opiopan/Track-Cam/README.md

trackCAM
---

trackCAM is a shield board for Raspberry Pi to realize 2 axis tracking camera controll capability and RC TX collaboration capability.

<p align="center">
description
</p>
