opiopan/Track-Cam/pcb/Track-Cam.brd

## EAGLE design pcb/Track-Cam.brd (2019-01-09)

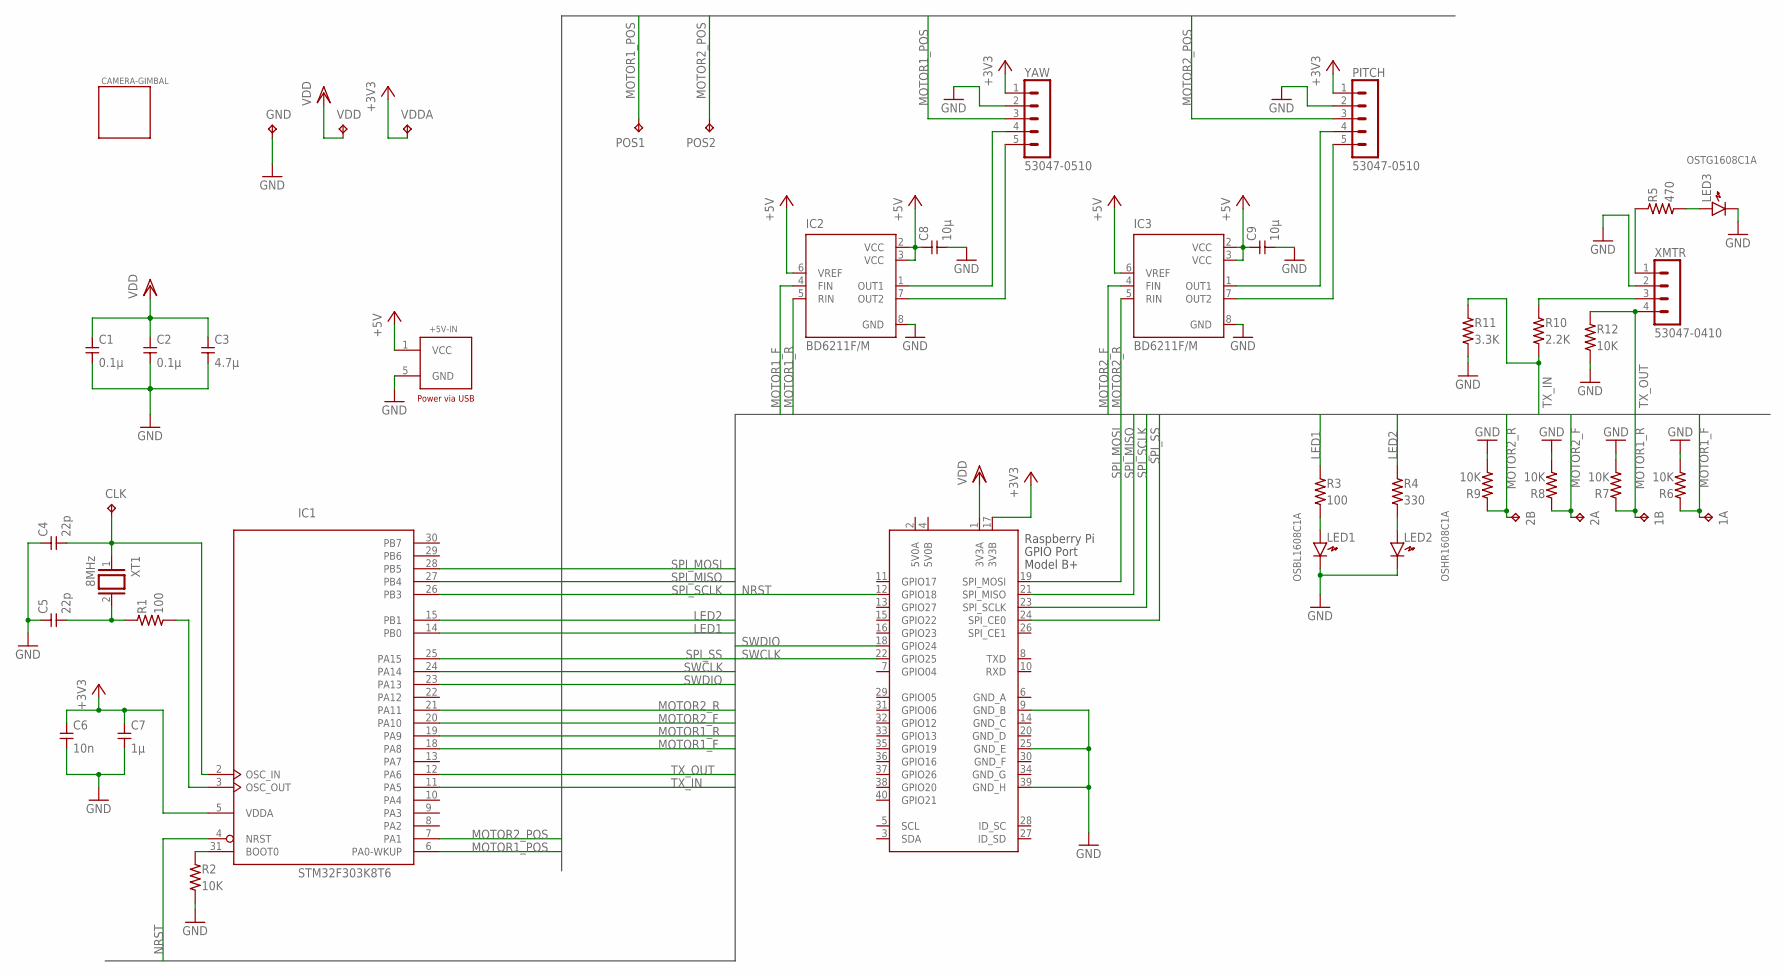
[picture p1: schematic Track-Cam.sch]

Parts:
1A, 1B, 2A, 2B: TPB1,27; B1,27
+5V-IN: MRUSB-2B-D14NI-S306/M; MICRO-USB-POWER/M
C1, C2: 0.1μ; SMD2012
C3: 4.7μ; SMD2012
C4, C5: 22p; SMD1608
C6: 10n; SMD2012
C7: 1μ; SMD2012
C8, C9: 10μ; SMD2012
CAMERA-GIMBAL: SG-90-CAMERA-MOUNT/NR; SG90-CAMERA-MOUNT-NR
CLK: TPB1,27; B1,27
GND: TPB1,27; B1,27
IC1: STM32F303K8T6; LQFP32-M
IC2, IC3: BD6211F/M; SOP8/M
LED1, LED2, LED3: LED1608
P1: RASPI_BOARD_B+#_HC; RASPI_BOARD_B+HAT_CF
PITCH: 53047-0510
POS1, POS2: TPB1,27; B1,27
R1, R3: 100; SMD2012
R2, R6, R7, R8, R9, R12: 10K; SMD2012
R4: 330; SMD2012
R5: 470; SMD2012
R10: 2.2K; SMD2012
R11: 3.3K; SMD2012
VDD: TPB1,27; B1,27
VDDA: TPB1,27; B1,27
XMTR: 53047-0410
XT1: 8MHz; QS
YAW: 53047-0510

Connections:
5V0A: P1.2 (5V0A)
5V0B: P1.4 (5V0B)
+3V3: C6.1, C7.1, IC1.5 (VDDA), P1.17 (3V3B), PITCH.1, VDDA.TP, YAW.1
+5V: +5V-IN.1 (VCC), C8.1, C9.1, IC2.2 (VCC), IC2.3 (VCC), IC2.6 (VREF), IC3.2 (VCC), IC3.3 (VCC), IC3.6 (VREF)
BOOT0: IC1.31 (BOOT0), R2.1
GND: +5V-IN.5 (GND), C1.2, C2.2, C3.2, C4.1, C5.1, C6.2, C7.2, C8.2, C9.2, GND.TP, IC1.16 (GND), IC1.32 (GND), IC2.8 (GND), IC3.8 (GND), LED1.K, LED2.K, LED3.K, P1.9 (GND_B), P1.25 (GND_E), P1.39 (GND_H), PITCH.2, R2.2, R6.2, R7.2, R8.2, R9.2, R11.2, R12.2, XMTR.2, YAW.2
GND_A: P1.6 (GND_A)
GND_C: P1.14 (GND_C)
GND_D: P1.20 (GND_D)
GND_F: P1.30 (GND_F)
GND_G: P1.34 (GND_G)
LED1: IC1.14 (PB0), R3.1
LED2: IC1.15 (PB1), R4.1
MOTOR1+: IC2.1 (OUT1), YAW.4
MOTOR1-: IC2.7 (OUT2), YAW.5
MOTOR1_F: 1A.TP, IC1.18 (PA8), IC2.4 (FIN), R6.1
MOTOR1_POS: IC1.6 (PA0-WKUP), POS1.TP, YAW.3
MOTOR1_R: 1B.TP, IC1.19 (PA9), IC2.5 (RIN), R7.1
MOTOR2+: IC3.1 (OUT1), PITCH.4
MOTOR2-: IC3.7 (OUT2), PITCH.5
MOTOR2_F: 2A.TP, IC1.20 (PA10), IC3.4 (FIN), R8.1
MOTOR2_POS: IC1.7 (PA1), PITCH.3, POS2.TP
MOTOR2_R: 2B.TP, IC1.21 (PA11), IC3.5 (RIN), R9.1
unnamed: C5.2, R1.1, XT1.2
unnamed: LED1.A, R3.2
unnamed: LED2.A, R4.2
unnamed: R5.1, XMTR.1
unnamed: LED3.A, R5.2
NRST: IC1.4 (NRST), P1.12 (GPIO18)
OSC_IN: C4.2, CLK.TP, IC1.2 (OSC_IN), XT1.1
OSC_OUT: IC1.3 (OSC_OUT), R1.2
SPI_MISO: IC1.27 (PB4), P1.21 (SPI_MISO)
SPI_MOSI: IC1.28 (PB5), P1.19 (SPI_MOSI)
SPI_SCLK: IC1.26 (PB3), P1.23 (SPI_SCLK)
SPI_SS: IC1.25 (PA15), P1.24 (SPI_CE0)
SWCLK: IC1.24 (PA14), P1.22 (GPIO25)
SWDIO: IC1.23 (PA13), P1.18 (GPIO24)
TX_IN: IC1.11 (PA5), R10.2, R11.1
TX_IN_5V: R10.1, XMTR.3
TX_OUT: IC1.12 (PA6), R12.1, XMTR.4
VDD: C1.1, C2.1, C3.1, IC1.1 (VDD), IC1.17 (VDD), P1.1 (3V3A), VDD.TP

Notes on the sheet:
OSBL1608C1A
OSHR1608C1A
OSTG1608C1A

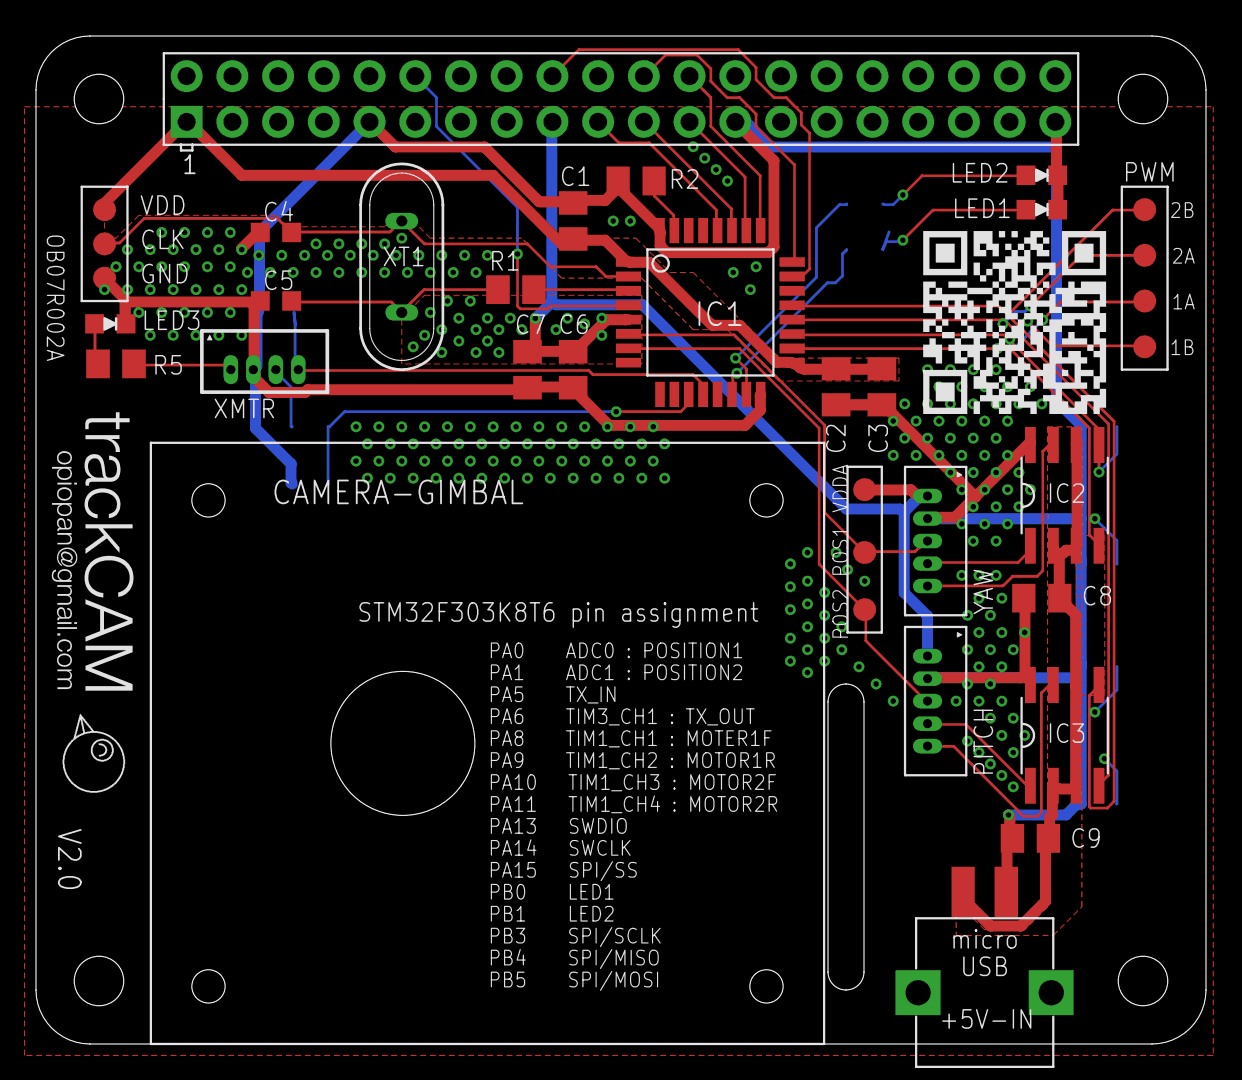
[picture p2: board Track-Cam.brd from above]

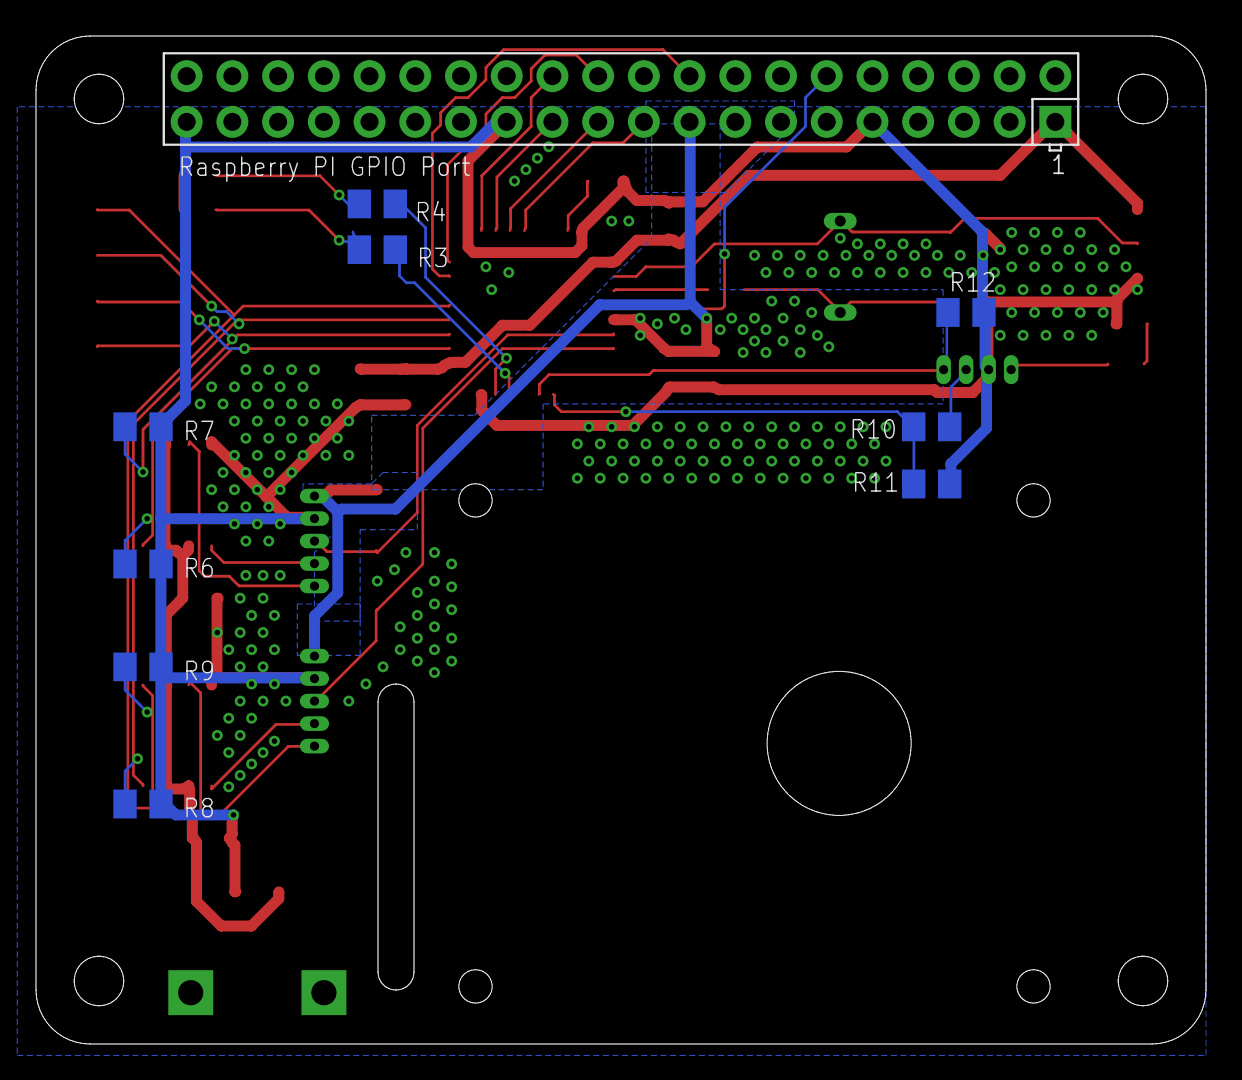
[picture p3: board Track-Cam.brd from below]

Board: 2 copper layers, 65.0 x 56.0 mm, 47 parts (9 on the bottom side), 34 nets.

Other parts of the board:
U$1: OPIOPAN-LOGO
U$2: TRACKCAM-LOGO
U$3: TRACKCAM-QRCODE
