opiopan/Track-Cam/firmware/projects/stm32f3/trackCamSTM32F3.ioc

Mcu.UserName=STM32F303K8Tx
PA0.Signal=ADC1_IN1
PA1.Signal=ADC1_IN2
PA10.Signal=S_TIM1_CH3
PA11.Signal=S_TIM1_CH4
PA13.Signal=SYS_JTMS-SWDIO
PA14.Signal=SYS_JTCK-SWCLK
PA5.Signal=GPIO_Input
PA6.Signal=GPIO_Output
PA8.Signal=S_TIM1_CH1
PA9.Signal=S_TIM1_CH2
PB0.Signal=GPIO_Output
PB1.Signal=GPIO_Output
PB3.Signal=SPI1_SCK
PB4.Signal=SPI1_MISO
PB5.Signal=SPI1_MOSI
