opiopan/Track-Cam/firmware/src/HostComm.c

/*
 * HostComm.c
 *
 *  Created on: 2017/03/12
 *      Author: opiopan@gmail.com
 */

#include "HostComm.h"
#include <string.h>

inline uint32_t convNE32(uint32_t* x)
{
    uint8_t* in = (uint8_t*) x;
#ifdef __ARM_BIG_ENDIAN
    return ((uint32_t)in[3]) << 24 | ((uint32_t)in[2]) << 16 |
    ((uint32_t)in[1]) << 8 | (uint32_t)in[0];
#else
    return ((uint32_t) in[0]) << 24 | ((uint32_t) in[1]) << 16
            | ((uint32_t) in[2]) << 8 | (uint32_t) in[3];
#endif
}

inline uint16_t convNE16(uint16_t* x)
{
    uint8_t* in = (uint8_t*) x;
#ifdef __ARM_BIG_ENDIAN
    return ((uint16_t)in[1]) << 8 | (uint16_t)in[0];
#else
    return ((uint16_t) in[0]) << 8 | (uint16_t) in[1];
#endif
}

/*---------------------------------------------------------------
 * Command handler
 *-------------------------------------------------------------*/
static int getServoMode(HostCommHandle* handle, uint8_t cmd, uint8_t* arg,
        int alen, uint8_t* respBuf, int rblen)
{
    if (alen != 0) {
        return 0;
    }
    RespGetServoMode* resp = (RespGetServoMode*) respBuf;
    resp->mode = SERVO_CONFIG(handle->servo, SERVO_CH_YAW).mode;

    return sizeof(*resp);
}

static int setServoMode(HostCommHandle* handle, uint8_t cmd, uint8_t* arg,
        int alen, uint8_t* respBuf, int rblen)
{
    if (alen != 0) {
        return 0;
    }
    uint8_t mode = cmd - CMD_SET_SERVO_MODE_IDLE + SERVO_IDLE;
    uint8_t lastMode = SERVO_CONFIG(handle->servo, 0).mode;
    int i;
    for (i = 0; i < SERVO_NUM; i++) {
        SERVO_CONFIG(handle->servo, i).mode = mode;
    }
    commitServoConfig(handle->servo);

    if (lastMode == SERVO_IDLE && mode != SERVO_IDLE) {
        LED_CONFIG(handle->led, LED_SEQ_LEVEL_MASTER).type[LED_BLUE] =
                LED_SEQ_TYPE_SERVO_RUNNING;
        LED_CONFIG(handle->led, LED_SEQ_LEVEL_MASTER).type[LED_RED] =
                LED_SEQ_TYPE_SERVO_RUNNING;
        commitLEDConfig(handle->led, LED_SEQ_LEVEL_MASTER);
    } else if (lastMode != SERVO_IDLE && mode == SERVO_IDLE) {
        LED_CONFIG(handle->led, LED_SEQ_LEVEL_MASTER).type[LED_BLUE] =
                LED_SEQ_TYPE_SERVO_IDLE;
        LED_CONFIG(handle->led, LED_SEQ_LEVEL_MASTER).type[LED_RED] =
                LED_SEQ_TYPE_SERVO_IDLE;
        commitLEDConfig(handle->led, LED_SEQ_LEVEL_MASTER);
    }

    return 0;
}

static int getServoPos(HostCommHandle* handle, uint8_t cmd, uint8_t* arg,
        int alen, uint8_t* respBuf, int rblen)
{
    if (alen != 0) {
        return 0;
    }
    RespGetServoPos* resp = (RespGetServoPos*) respBuf;
    int i;
    for (i = 0; i < SERVO_NUM; i++) {
        int16_t pos = getServoPosition(handle->servo, i);
        resp->pos[i] = convNE16((uint16_t*) &pos);
    }
    return sizeof(*resp);
}

static int getServoPosRaw(HostCommHandle* handle, uint8_t cmd, uint8_t* arg,
        int alen, uint8_t* respBuf, int rblen)
{
    if (alen != 0) {
        return 0;
    }
    RespGetServoPosRaw* resp = (RespGetServoPosRaw*) respBuf;
    int i;
    for (i = 0; i < SERVO_NUM; i++) {
        int16_t pos = getServoPositionRaw(handle->servo, i);
        resp->posRaw[i] = convNE16((uint16_t*) &pos);
    }
    return sizeof(*resp);
}

static int getServoPosTime(HostCommHandle* handle, uint8_t cmd, uint8_t* arg,
        int alen, uint8_t* respBuf, int rblen)
{
    if (alen != 0) {
        return 0;
    }
    RespGetServoPosTime* resp = (RespGetServoPosTime*) respBuf;
    int32_t time = getServoTime(handle->servo);
    resp->time = convNE32((uint32_t*)&time);
    int i;
    for (i = 0; i < SERVO_NUM; i++) {
        int16_t pos = getServoPosition(handle->servo, i);
        resp->pos[i] = convNE16((uint16_t*) &pos);
    }
    return sizeof(*resp);
}


static int getServoPosRawTime(HostCommHandle* handle, uint8_t cmd, uint8_t* arg,
        int alen, uint8_t* respBuf, int rblen)
{
    if (alen != 0) {
        return 0;
    }
    RespGetServoPosRawTime* resp = (RespGetServoPosRawTime*) respBuf;
    int32_t time = getServoTime(handle->servo);
    resp->time = convNE32((uint32_t*)&time);
    int i;
    for (i = 0; i < SERVO_NUM; i++) {
        int16_t pos = getServoPositionRaw(handle->servo, i);
        resp->posRaw[i] = convNE16((uint16_t*) &pos);
    }
    return sizeof(*resp);
}

static int getServoFreq(HostCommHandle* handle, uint8_t cmd, uint8_t* arg,
        int alen, uint8_t* respBuf, int rblen)
{
    if (alen != 0) {
        return 0;
    }
    RespGetServoFreq* resp = (RespGetServoFreq*) respBuf;
    int32_t freq = getServoSamplingFrequency(handle->servo);
    resp->frequency = convNE32((uint32_t*)&freq);
    return sizeof(*resp);
}

static int setServoTheta(HostCommHandle* handle, uint8_t cmd, uint8_t* arg,
        int alen, uint8_t* respBuf, int rblen)
{
    if (alen != sizeof(ArgSetServoTheta)) {
        return 0;
    }
    ArgSetServoTheta* in = (ArgSetServoTheta*) arg;

    int i;
    for (i = 0; i < SERVO_NUM; i++) {
        int16_t* target = &SERVO_CONFIG(handle->servo, i).target;
        *target = convNE16((uint16_t*)(in->theta + i));
        *target = MAX(*target, 0);
        *target = MIN(*target, SERVO_POS_MAX);
        SERVO_CONFIG(handle->servo,i).velocity = 0;
    }

    commitServoConfig(handle->servo);

    return 0;
}

static int setServoDeltaTheta(HostCommHandle* handle, uint8_t cmd, uint8_t* arg,
        int alen, uint8_t* respBuf, int rblen)
{
    if (alen != sizeof(ArgSetServoDeltaTheta)) {
        return 0;
    }
    ArgSetServoDeltaTheta* in = (ArgSetServoDeltaTheta*) arg;

    int i;
    for (i = 0; i < SERVO_NUM; i++) {
        int16_t* target = &SERVO_CONFIG(handle->servo, i).target;
        *target += convNE16((uint16_t*)(in->deltaTheta + i));
        *target = MAX(*target, 0);
        *target = MIN(*target, SERVO_POS_MAX);
        SERVO_CONFIG(handle->servo,i).velocity = 0;
    }

    commitServoConfig(handle->servo);

    return 0;
}

static int setServoDuty(HostCommHandle* handle, uint8_t cmd, uint8_t* arg,
        int alen, uint8_t* respBuf, int rblen)
{
    if (alen != sizeof(ArgSetServoDuty)) {
        return 0;
    }
    ArgSetServoDuty* in = (ArgSetServoDuty*) arg;

    int i;
    for (i = 0; i < SERVO_NUM; i++) {
        int16_t* duty = &SERVO_CONFIG(handle->servo, i).duty;
        *duty = convNE16((uint16_t*)(in->duty + i));
        *duty = MAX(*duty, -SERVO_DUTY_MAX);
        *duty = MIN(*duty, SERVO_DUTY_MAX);
        SERVO_CONFIG(handle->servo,i).velocity = 0;
    }

    commitServoConfig(handle->servo);

    return 0;
}

static int setServoThetaDuty(HostCommHandle* handle, uint8_t cmd, uint8_t* arg,
        int alen, uint8_t* respBuf, int rblen)
{
    if (alen != sizeof(ArgSetServoThetaDuty)) {
        return 0;
    }
    ArgSetServoThetaDuty* in = (ArgSetServoThetaDuty*) arg;

    int i;
    for (i = 0; i < SERVO_NUM; i++) {
        int16_t* target = &SERVO_CONFIG(handle->servo, i).target;
        *target = convNE16((uint16_t*)(in->theta + i));
        *target = MAX(*target, 0);
        *target = MIN(*target, SERVO_POS_MAX);
        int16_t* duty = &SERVO_CONFIG(handle->servo, i).duty;
        *duty = convNE16((uint16_t*)(in->duty + i));
        *duty = MAX(*duty, 0);
        *duty = MIN(*duty, SERVO_DUTY_MAX);
        SERVO_CONFIG(handle->servo,i).velocity = 0;
    }

    commitServoConfig(handle->servo);

    return 0;
}

static int setServoDeltaThetaDuty(HostCommHandle* handle, uint8_t cmd,
        uint8_t* arg, int alen, uint8_t* respBuf, int rblen)
{
    if (alen != sizeof(ArgSetServoDeltaThetaDuty)) {
        return 0;
    }
    ArgSetServoDeltaThetaDuty* in = (ArgSetServoDeltaThetaDuty*) arg;

    int i;
    for (i = 0; i < SERVO_NUM; i++) {
        int16_t* target = &SERVO_CONFIG(handle->servo, i).target;
        *target += convNE16((uint16_t*)(in->deltaTheta + i));
        *target = MAX(*target, 0);
        *target = MIN(*target, SERVO_POS_MAX);
        int16_t* duty = &SERVO_CONFIG(handle->servo, i).duty;
        *duty = convNE16((uint16_t*)(in->duty + i));
        *duty = MAX(*duty, 0);
        *duty = MIN(*duty, SERVO_DUTY_MAX);
        SERVO_CONFIG(handle->servo,i).velocity = 0;
    }

    commitServoConfig(handle->servo);

    return 0;
}

static int setServoThetaVelocity(HostCommHandle* handle, uint8_t cmd,
        uint8_t* arg, int alen, uint8_t* respBuf, int rblen)
{
    if (alen != sizeof(ArgSetServoThetaVelocity)) {
        return 0;
    }
    ArgSetServoThetaVelocity* in = (ArgSetServoThetaVelocity*) arg;

    int i;
    for (i = 0; i < SERVO_NUM; i++) {
        int16_t* target = &SERVO_CONFIG(handle->servo, i).target;
        *target = convNE16((uint16_t*)(in->theta + i));
        *target = MAX(*target, 0);
        *target = MIN(*target, SERVO_POS_MAX);
        uint16_t* velocity = &SERVO_CONFIG(handle->servo, i).velocity;
        *velocity = convNE16((uint16_t*)(in->velocity + i));
    }

    commitServoConfig(handle->servo);

    return 0;
}

static int setServoDeltaThetaVelocity(HostCommHandle* handle, uint8_t cmd,
        uint8_t* arg, int alen, uint8_t* respBuf, int rblen)
{
    if (alen != sizeof(ArgSetServoDeltaThetaDuty)) {
        return 0;
    }
    ArgSetServoDeltaThetaVelocity* in = (ArgSetServoDeltaThetaVelocity*) arg;

    int i;
    for (i = 0; i < SERVO_NUM; i++) {
        int16_t* target = &SERVO_CONFIG(handle->servo, i).target;
        *target += convNE16((uint16_t*)(in->deltaTheta + i));
        *target = MAX(*target, 0);
        *target = MIN(*target, SERVO_POS_MAX);
        uint16_t* velocity = &SERVO_CONFIG(handle->servo, i).velocity;
        *velocity = convNE16((uint16_t*)(in->velocity + i));
    }

    commitServoConfig(handle->servo);

    return 0;
}

static int setLEDMode(HostCommHandle* handle, uint8_t cmd, uint8_t* arg,
        int alen, uint8_t* respBuf, int rblen)
{
    if (alen != sizeof(ArgSetLEDMode)) {
        return 0;
    }
    ArgSetLEDMode* in = (ArgSetLEDMode*) arg;

    int i;
    for (i = 0; i < LED_NUM; i++) {
        LEDConfig* config = &LED_CONFIG(handle->led, LED_SEQ_LEVEL_USER);
        config->type[i] = in->mode[i];
    }
    commitLEDConfig(handle->led, LED_SEQ_LEVEL_USER);

    return 0;
}

static int registerLEDSequence(HostCommHandle* handle, uint8_t cmd,
        uint8_t* arg, int alen, uint8_t* respBuf, int rblen)
{
    if (alen != sizeof(ArgRegisterLEDSequence)) {
        return 0;
    }
    ArgRegisterLEDSequence* in = (ArgRegisterLEDSequence*) arg;

    handle->led->userSeq = in->sequence;
    commitLEDUserSeq(handle->led);

    return 0;
}

/*---------------------------------------------------------------
 * Dispatch table
 *-------------------------------------------------------------*/
static struct {
    int command;
    int argsize;
    int (*func)(HostCommHandle* handle, uint8_t cmd, uint8_t* arg,
                int alen, uint8_t* respBuf, int rblen);
} dispatch[] = {
    {CMD_GET_SERVO_MODE, 0, getServoMode},
    {CMD_SET_SERVO_MODE_IDLE, 0, setServoMode},
    {CMD_SET_SERVO_MODE_THETA, 0, setServoMode},
    {CMD_SET_SERVO_MODE_DUTY, 0, setServoMode},
    {CMD_SET_SERVO_MODE_THETA_DUTY, 0, setServoMode},

    {CMD_GET_SERVO_POS, 0, getServoPos},
    {CMD_GET_SERVO_POS_RAW, 0, getServoPosRaw},
    {CMD_GET_SERVO_POS_TIME, 0, getServoPosTime},
    {CMD_GET_SERVO_POS_RAW_TIME, 0, getServoPosRawTime},
    {CMD_GET_SERVO_FREQ, 0, getServoFreq},

    {CMD_SET_SERVO_THETA, sizeof(ArgSetServoTheta), setServoTheta},
    {CMD_SET_SERVO_DELTA_THETA, sizeof(ArgSetServoDeltaTheta), setServoDeltaTheta},
    {CMD_SET_SERVO_DUTY, sizeof(ArgSetServoDuty), setServoDuty},
    {CMD_SET_SERVO_THETA_DUTY, sizeof(ArgSetServoThetaDuty), setServoThetaDuty },
    {CMD_SET_SERVO_DELTA_THETA_DUTY, sizeof(ArgSetServoDeltaThetaDuty), setServoDeltaThetaDuty},
    {CMD_SET_SERVO_THETA_VELOCITY, sizeof(ArgSetServoThetaVelocity), setServoThetaVelocity},
    {CMD_SET_SERVO_DELTA_THETA_VELOCITY, sizeof(ArgSetServoDeltaThetaVelocity), setServoDeltaThetaVelocity},

    {CMD_SET_LED_MODE, sizeof(ArgSetLEDMode), setLEDMode},
    {CMD_REGISTER_LED_SEQUENCE, sizeof(ArgRegisterLEDSequence), registerLEDSequence },
    {CMD_INVALID, 0, NULL}
};

static uint8_t dispatchIdx[256];

/*---------------------------------------------------------------
 * Host Communication functions
 *-------------------------------------------------------------*/
int initHostComm(HostCommHandle* handle, LEDHandle* led, ServoHandle* servo)
{
    memset(dispatchIdx, CMD_INVALID, sizeof(dispatchIdx));
    int i;
    for (i = 0; dispatch[i].func; i++) {
        dispatchIdx[dispatch[i].command] = i;
    }

    handle->led = led;
    handle->servo = servo;
    return 0;
}

int deinitHostComm(HostCommHandle* handle)
{
    handle->servo = NULL;
    return 0;
}

int validateHostCommand(uint8_t cmd)
{
    uint8_t idx = dispatchIdx[cmd];
    if (idx == CMD_INVALID) {
        return -1;
    } else {
        return dispatch[idx].argsize;
    }
}

int processHostCommand(HostCommHandle* handle, uint8_t cmd, uint8_t* arg,
        int argLength, uint8_t* outBuf, int outBufLength)
{
    uint8_t idx = dispatchIdx[cmd];
    if (idx != CMD_INVALID) {
        return dispatch[idx].func(handle, cmd, arg, argLength, outBuf,
                outBufLength);
    }
    return 0;
}
