opiopan/Track-Cam/(commit log)

2017-02-09 enlarge pads
    [Track-Cam.brd, Track-Cam.sch]
2017-02-11 fix issue of unconnected path
    [Track-Cam.brd, Track-Cam.sch]
2017-02-11 add polygon net
    [Track-Cam.brd, Track-Cam.sch]
2017-02-12 replaced components to confirm to actual gimbal size
    [Track-Cam.brd, Track-Cam.sch]
2017-02-12 optimized grand path
    [Track-Cam.brd]
2017-02-12 apply solid wiring
    [Track-Cam.brd]
2017-02-13 improve silk design
    [Track-Cam.brd, Track-Cam.sch]
2017-02-13 add via holes for noise immunity
    [Track-Cam.brd]
2017-02-14 fix some bug
    [Track-Cam.brd, Track-Cam.sch]
2017-02-16 optimize wiring
    [Track-Cam.brd, Track-Cam.sch]
2017-02-17 fix some wiring bug
    [Track-Cam.brd, Track-Cam.sch]
2017-02-17 fix 5v line bug
    [Track-Cam.brd, Track-Cam.sch]
2017-03-01 fix BOM for 1st production
    [Track-Cam.brd, Track-Cam.sch]
2017-03-09 add firmware template
    [Track-Cam.brd, Track-Cam.sch]
2017-03-16 add LED capability
2017-03-19 impremented servo cotrol function
2017-03-20 add raspberry pi debug environment
2017-03-20 fix servo control issue
    [Servo.c, Servo.h]
2017-03-26 implement PID feedback control
2017-04-02 improve PID controller
2017-04-07 improve PID controler
2017-04-14 change pcb design as connecting with Rasbery Pi by SPI
    [Track-Cam.brd, Track-Cam.sch]
2017-04-14 improved pcb pattern
    [Track-Cam.brd]
2017-04-18 modify firmware for V2.0 pcb
2017-04-23 add a project for STM32F3x
    [stm32f0.cfg, stm32f3.cfg]
2017-04-23 fix a issue of SPI protcol
    [HostCommCommon.h, TrackCam.c, main.c]
2017-04-25 add library and cli for Raspberry Pi
2017-04-26 determining servo position function was added to raspbery pi command
2017-04-26 add servo control feature to cli on Raspberry Pi
2017-04-26 fix TIM1 configuration bug
    [main.c, trackCamSTM32F3.ioc]
2017-04-29 change PID parameters
2017-04-30 add service on Raspberry Pi
    [reset.cfg]
2017-04-30 fix a issue of service on raspberry pi
2017-05-01 improve PID control logic
2017-05-19 add a function to retrieve servo position with time
2017-05-21 improve error handler in firmware
    [HostComm.c, HostCommCommon.h, Servo.h, TrackCam.c, TrackCam.h, main.c]
2017-05-21 improve servo position capturing function
2017-05-27 change pcb cad version
2017-06-08 modify trackcam servo comannd with -c option to accept sub second value
2019-01-09 optimize pcb design to suport 3D model
    [Track-Cam.brd, Track-Cam.sch]
