opiopan/Track-Cam/(notices)

Notices in the files:
firmware/projects/stm32f0/Src/main.c:
(C) COPYRIGHT STMicroelectronics *****END OF FILE
